austynloehr/stm32_reaction_wheel/Hardware/Balance_Controller/Render.png

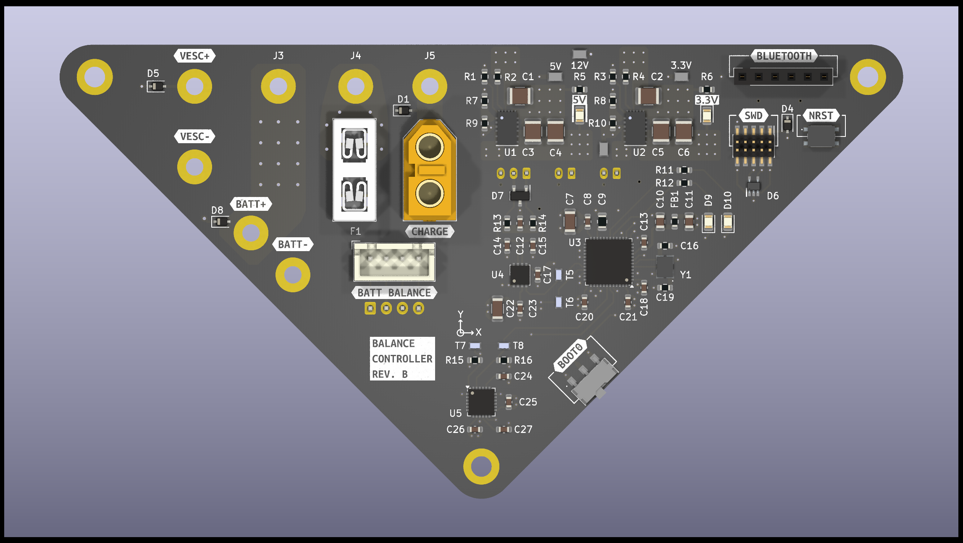
Hardware/Balance_Controller/Render.png
