austynloehr/stm32_reaction_wheel/Resources/Markdowns/HC05.md

# HC-05 Documentation

## AT Mode Configuration
*Note: USB to TTL serial adapter is required for configuration. Ensure logic levels are 3.3V. Recommend [this adapter](https://www.amazon.com/DSD-TECH-Adapter-FT232RL-Compatible/dp/B07BBPX8B8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).*<br>

1. Plug-in TTL adapter to computer
2. Set TTL adapter to 3.3V logic level
3. While holding mode button, power HC-05 with 5V supply separate from TTL adapter. Verify LED is blinking
    * Ensure supply and TTL GND's are connected
4. Open serial port monitor of choice (I am using Arduino serial monitor)
5. Default serial settings are 38400 baud, Both NL & CR
6. Send "AT" command, verify "OK" response
7. Get module MAC address. Take note of this for later use in [ble_serial_monitor.sh](../Scripts/ble_serial_monitor.sh)

        AT+ADDR?
8. Set serial baud rate, verify "OK" response
        
        AT+UART=460800,0,0
9. HC-05 should now be configured for use with STM32 UART config
