austynloehr/stm32_reaction_wheel/Hardware/Balance_Controller/EBOM_RevB.xlsx

Balance Controller EBOM (Rev. B)
# | Designator | Qty | Value | Footprint | Mfg Part # | Manufacturer
1 | C9 | 1 | 4.7u | Resistor_SMD:R_0805_2012Metric | GRM21BZ71E475KE15L | Murata
2 | C24 | 1 | 2.2n | Capacitor_SMD:C_0603_1608Metric | GRT1885C1H222JA02D | Murata
3 | C26 | 1 | 10n | Capacitor_SMD:C_0603_1608Metric | GRM1885C1H103JA01J | Murata
4 | D6 | 1 | ESDALC6V1W5 | ESDALC6V1W5:SOT65P210X110-5N | ESDALC6V1W5 | ST
5 | D7 | 1 | NUP2105L | Package_TO_SOT_SMD:SOT-23 | NUP2105L | Diotec
6 | D9 | 1 | GRN | LED_SMD:LED_0805_2012Metric | 150080GS75000 | Wurth Elektronik
7 | D11 | 1 | VESD03A2-03G-G3-08 | Package_TO_SOT_SMD:SOT-323_SC-70 | VESD03A2-03G-G3-08 | Vishay
8 | F1 | 1 | 20A | 534-3568:3568 | 3568 | Keystone Electronics
9 | FB1 | 1 | 120R | Resistor_SMD:R_0603_1608Metric | BLM18KG121TN1D | Murata
10 | J1 | 1 | HC-05 | Connector_PinSocket_2.54mm:PinSocket_1x06_P2.54mm_Vertical | 61300611821 | Wurth Elektronik
11 | J6 | 1 | SWD | Connector_PinHeader_1.27mm:PinHeader_2x05_P1.27mm_Vertical_SMD | FTSH-105-01-LM-DV-K-P-TR | Samtec
12 | J7 | 1 | CHARGE | Connector_AMASS:AMASS_XT60-F_1x02_P7.20mm_Vertical | XT60PB-F | AMASS
13 | J10 | 1 | BAL_BATT_A | Connector_JST:JST_XH_B4B-XH-A_1x04_P2.50mm_Vertical | B4B-XH-A | JST
14 | J12 | 1 | ENABLE | Connector_JST:JST_PH_B2B-PH-K_1x02_P2.00mm_Vertical | B2B-PH-K | JST
15 | J13 | 1 | RGB_LED | Connector_JST:JST_PH_B2B-PH-K_1x02_P2.00mm_Vertical | B2B-PH-K | JST
16 | J14 | 1 | CAN | Connector_JST:JST_PH_B3B-PH-K_1x03_P2.00mm_Vertical | B3B-PH-K | JST
17 | J15 | 1 | BAL_BATT_B | Connector_JST:JST_XH_B4B-XH-A_1x04_P2.50mm_Vertical | B4B-XH-A | JST
18 | R1 | 1 | 53.6k | Resistor_SMD:R_0603_1608Metric | ERJ-PA3F5362V | Panasonic
19 | R3 | 1 | 39k | Resistor_SMD:R_0603_1608Metric | ERJ-UP3J393V | Panasonic
20 | R5 | 1 | 523 | Resistor_SMD:R_0603_1608Metric | ERJ-PA3F5230V | Panasonic
21 | R7 | 1 | 34k | Resistor_SMD:R_0603_1608Metric | ERJ-PB3D3402V | Panasonic
22 | R8 | 1 | 40.2k | Resistor_SMD:R_0603_1608Metric | RCS060340K2FKEA | Vishay
23 | R9 | 1 | 6.49k | Resistor_SMD:R_0603_1608Metric | ERJ-PA3F6491V | Panasonic
24 | R10 | 1 | 12.7k | Resistor_SMD:R_0603_1608Metric | CRCW060312K7FKEAHP | Vishay
25 | R12 | 1 | 15 | Resistor_SMD:R_0603_1608Metric | ERJ-UP3F15R0V | Panasonic
26 | SW1 | 1 | NRST | PTS815_SJG_250_SMTR_LFS:PTS815SJG250SMTRLFS | PTS815 SJG 250 SMTR LFS | C&K
27 | SW2 | 1 | BOOT0 | AYZ0102AURLC:AYZ0102AURLC | AYZ0102AURLC | C&K
28 | U3 | 1 | STM32F412CGU6 | STM32F412:QFN-48-1EP_7x7mm_P0.5mm_EP5.6x5.6mm | STM32F412CGU6 | ST
29 | U4 | 1 | TJA1051TK-3 | Package_DFN_QFN:DFN-8-1EP_3x3mm_P0.65mm_EP1.55x2.4mm | TJA1051TK/3,118 | NXP
30 | U5 | 1 | MPU-6050 | MPU6050:InvenSense_QFN-24_4x4mm_P0.5mm | MPU-6050 | TDK InvenSense
31 | Y1 | 1 | NX3225SA-16.000 | NX3225SA-16.000M-STD-CRS-2:NX3225SA16000MSTDCRS2 | NX3225SA-16.000M-STD-CRS-2 | NDK
32 | C7,C22 | 2 | 10u | Capacitor_SMD:C_1206_3216Metric | GRM31CR71E106MA12L | Murata
33 | C10,C11 | 2 | 1u | Capacitor_SMD:C_0805_2012Metric | GRM21BR71C105KA01K | Murata
34 | C12,C23 | 2 | 47n | Capacitor_SMD:C_0603_1608Metric | GCJ188R71C473KA01D | Murata
35 | C14,C15 | 2 | 100p | Capacitor_SMD:C_0603_1608Metric | GCM1885C1H101JA16J | Murata
36 | C16,C19 | 2 | 6p | Resistor_SMD:R_0603_1608Metric | GRM1885C2A6R0DA01D | Murata
37 | R2,R4 | 2 | 100k | Resistor_SMD:R_0603_1608Metric | ERJ-UP3F1003V | Panasonic
38 | R6,R11 | 2 | 220 | Resistor_SMD:R_0603_1608Metric | ERJ-UP3J221V | Panasonic
39 | R13,R14 | 2 | 60 | Resistor_SMD:R_0603_1608Metric | ERJ-UP3F60R4V | Panasonic
40 | R15,R16 | 2 | 4.7k | Resistor_SMD:R_0603_1608Metric | MCT0603MD4701BP500 | Vishay
41 | R17,R18 | 2 | 10k | Resistor_SMD:R_0603_1608Metric | ESR03EZPJ103 | ROHM
42 | U1,U2 | 2 | MPM3610GQV-P | QFN3p0x5p0x1p6_MPM3610_MNP | MPM3610GQV-P | Monolithic Power Systems
43 | D1,D5,D8 | 3 | D_TVS | Diode_SMD:D_SOD-323 | PJGBLC12CR100001 | Panjit
44 | D2,D3,D10 | 3 | RED | LED_SMD:LED_0805_2012Metric | 150080SS75000 | Wurth Elektronik
45 | D4,D12,D13,D14 | 4 | SC1533-01FTG | Diode_SMD:D_SOD-323 | SC1533-01FTG | Littelfuse
46 | T1,T2,T3,T4 | 4 | TestPoint | RCT-0C:RCT-0C | RCT-0C | TE
47 | T5,T6,T7,T8 | 4 | TestPoint | RCU-0C:TP+195X110 | RCU-0C | TE
48 | C1,C2,C3,C4,C5,C6 | 6 | 22u | Capacitor_SMD:C_1210_3225Metric | GRM32ER71E226KE15L | Murata
49 | C8,C13,C17,C18,C20,C21,C25,C27,C28 | 9 | 100n | Capacitor_SMD:C_0603_1608Metric | GRM188R72A104KA35J | Murata
