austynloehr/stm32_reaction_wheel/Hardware/Balance_Controller/Components/LIB_3568/3568/3D/3568.stp

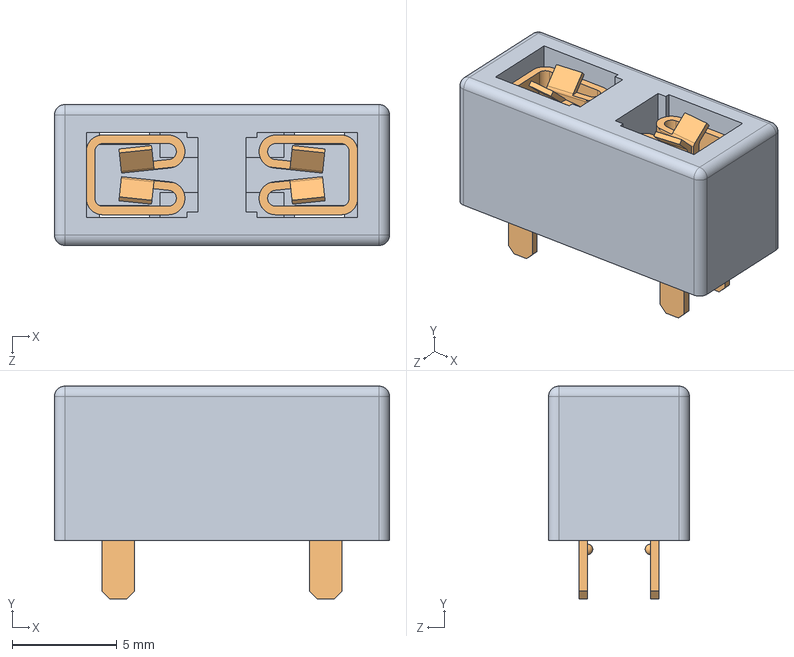
[picture p2: CAD file, 2024-02-08]
Hardware/Balance_Controller/Components/LIB_3568/3568/3D/3568.stp
16.0 x 10.2 x 6.73 mm
