austynloehr/stm32_reaction_wheel/Hardware/Balance_Controller/Components/LIB_AYZ0102AURLC/AYZ0102AURLC/3D/AYZ0102AURLC.stp

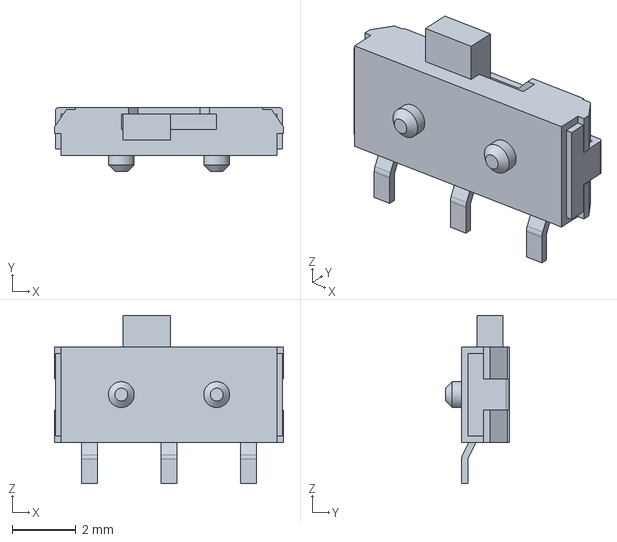
[picture p3: CAD file, 2024-02-08]
Hardware/Balance_Controller/Components/LIB_AYZ0102AURLC/AYZ0102AURLC/3D/AYZ0102AURLC.stp
7.20 x 2.00 x 5.29 mm
