austynloehr/stm32_reaction_wheel/Hardware/Balance_Controller/Components/LIB_ESDALC6V1W5/3D/ESDALC6V1W5.stp

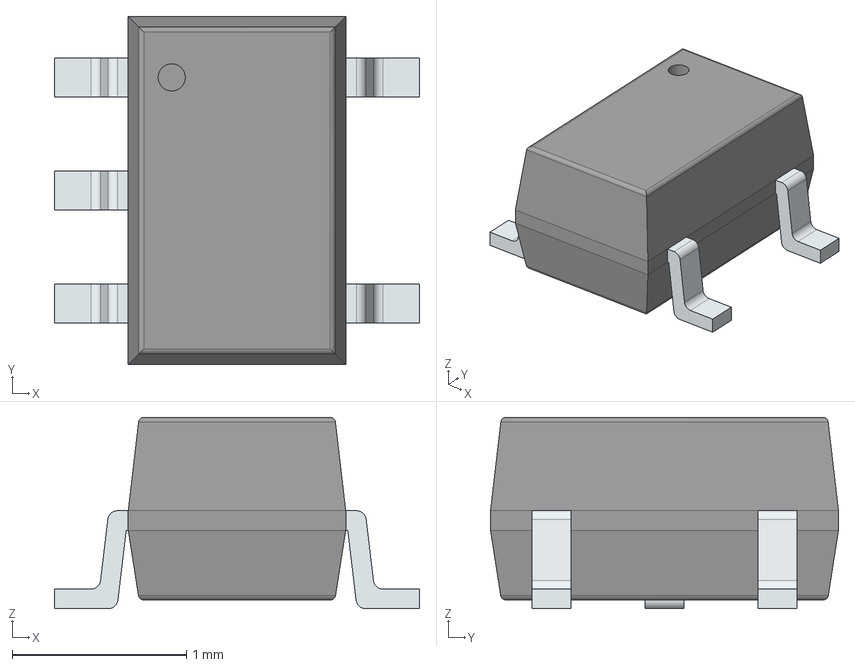
[picture p4: CAD file, 2024-03-23]
Hardware/Balance_Controller/Components/LIB_ESDALC6V1W5/3D/ESDALC6V1W5.stp
2.10 x 2.00 x 1.10 mm
PinsArrayL
PinsArrayR
