austynloehr/stm32_reaction_wheel/Hardware/Balance_Controller/Components/LIB_MCP111T-195I_LB/MCP111T-195I_LB/3D/MCP111T-195I_LB.stp

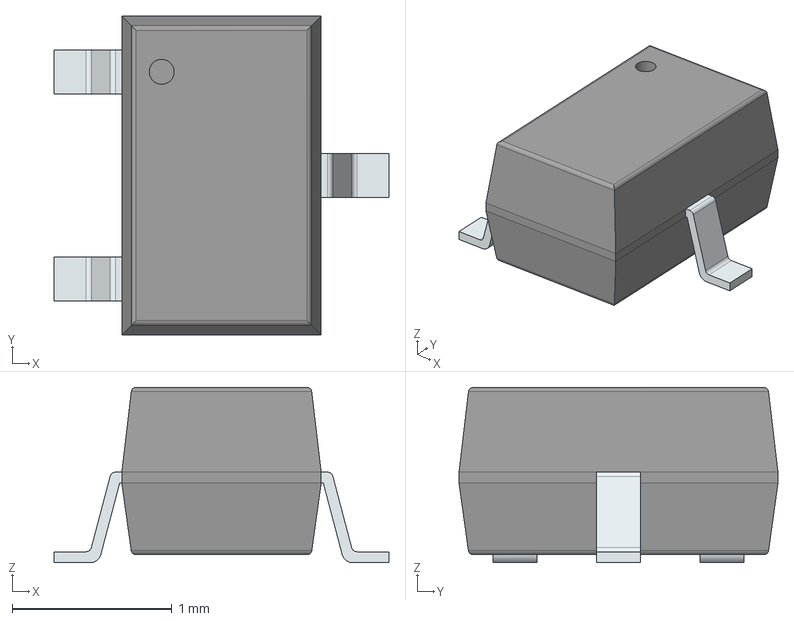
[picture p5: CAD file, 2024-02-08]
Hardware/Balance_Controller/Components/LIB_MCP111T-195I_LB/MCP111T-195I_LB/3D/MCP111T-195I_LB.stp
2.10 x 2.00 x 1.10 mm
PinsArrayL
FilletPinR
