austynloehr/stm32_reaction_wheel/Hardware/Balance_Controller/Components/LIB_PTS815_SJG_250_SMTR_LFS/PTS815_SJG_250_SMTR_LFS/3D/PTS815_SJG_250_SMTR_LFS.stp

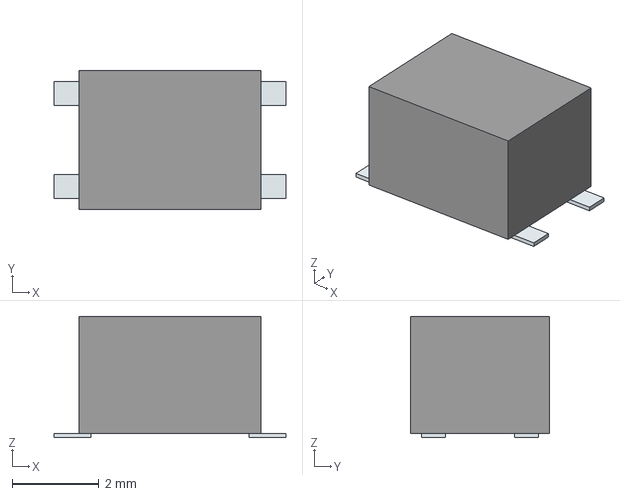
[picture p6: CAD file, 2024-02-08]
Hardware/Balance_Controller/Components/LIB_PTS815_SJG_250_SMTR_LFS/PTS815_SJG_250_SMTR_LFS/3D/PTS815_SJG_250_SMTR_LFS.stp
5.36 x 3.20 x 2.80 mm
Pins
