austynloehr/stm32_reaction_wheel/Hardware/Balance_Controller/Components/LIB_RCT-0C/c-1625854-2-ba-3d.stp

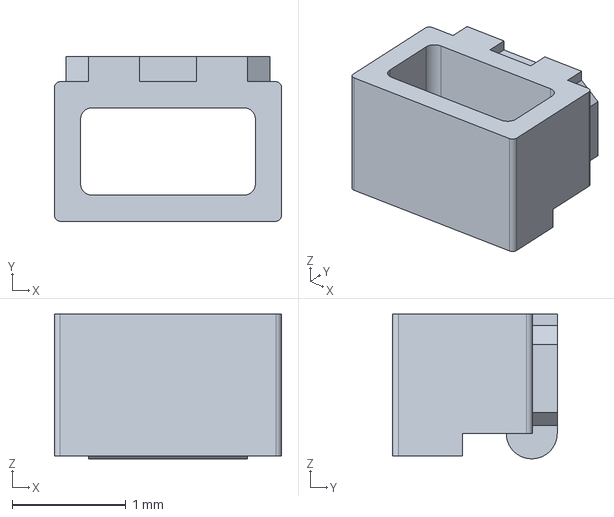
[picture p7: CAD file, 2024-03-23]
Hardware/Balance_Controller/Components/LIB_RCT-0C/c-1625854-2-ba-3d.stp
2.00 x 1.45 x 1.28 mm
