austynloehr/stm32_reaction_wheel/Hardware/Balance_Controller/Components/LIB_SBM3060VDC-AU_R2_006A1/SBM3060VDC-AU_R2_006A1/3D/SBM3060VDC-AU_R2_006A1.stp

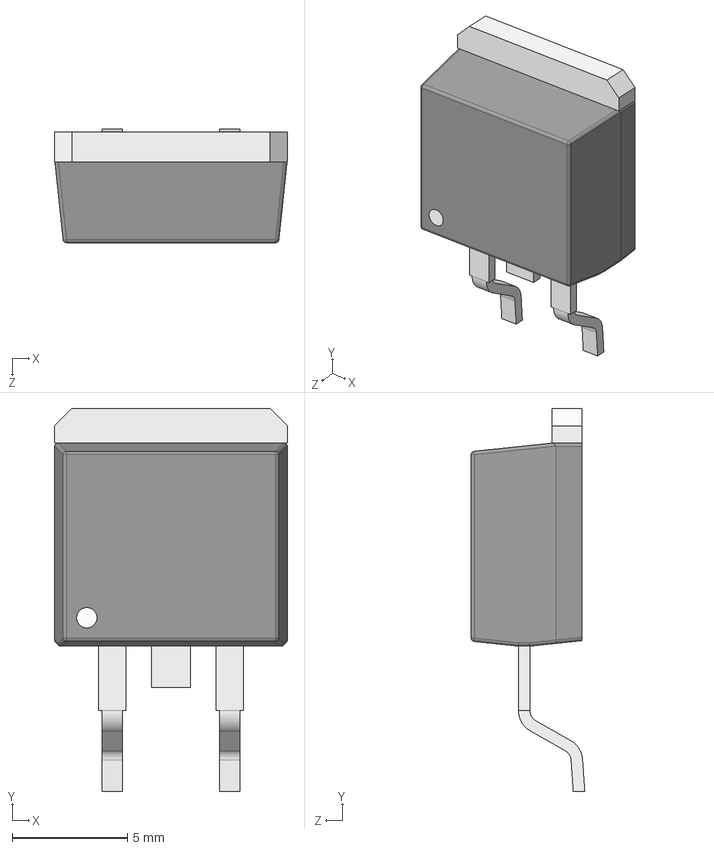
[picture p8: CAD file, 2024-02-08]
Hardware/Balance_Controller/Components/LIB_SBM3060VDC-AU_R2_006A1/SBM3060VDC-AU_R2_006A1/3D/SBM3060VDC-AU_R2_006A1.stp
10.1 x 16.6 x 4.92 mm
