austynloehr/stm32_reaction_wheel/Hardware/Balance_Controller/Components/NX3225SA-16.000M-STD-CRS-2/3D/NX3225SA-16.000M-STD-CRS-2.stp

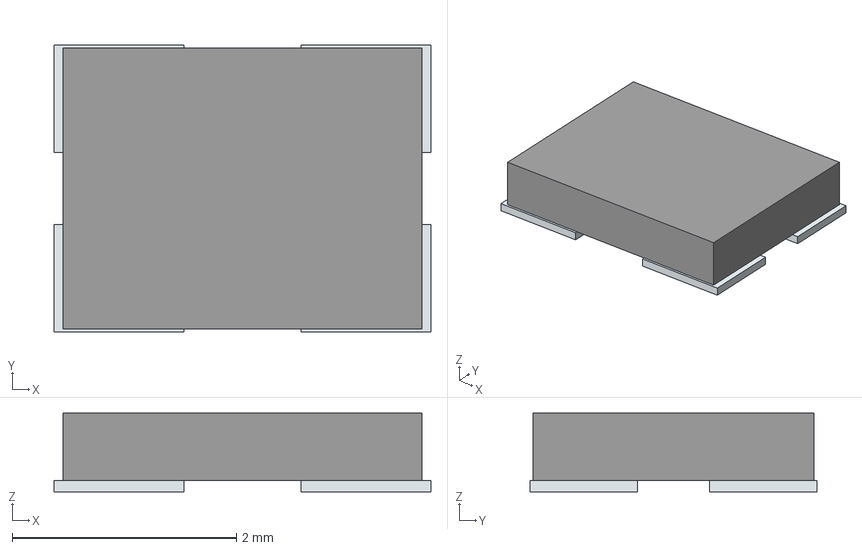
[picture p9: CAD file, 2024-02-08]
Hardware/Balance_Controller/Components/NX3225SA-16.000M-STD-CRS-2/3D/NX3225SA-16.000M-STD-CRS-2.stp
3.36 x 2.56 x 0.7 mm
Pins
