austynloehr/stm32_reaction_wheel/Hardware/Balance_Controller/Components/RCU-0C/RCU-0C.step

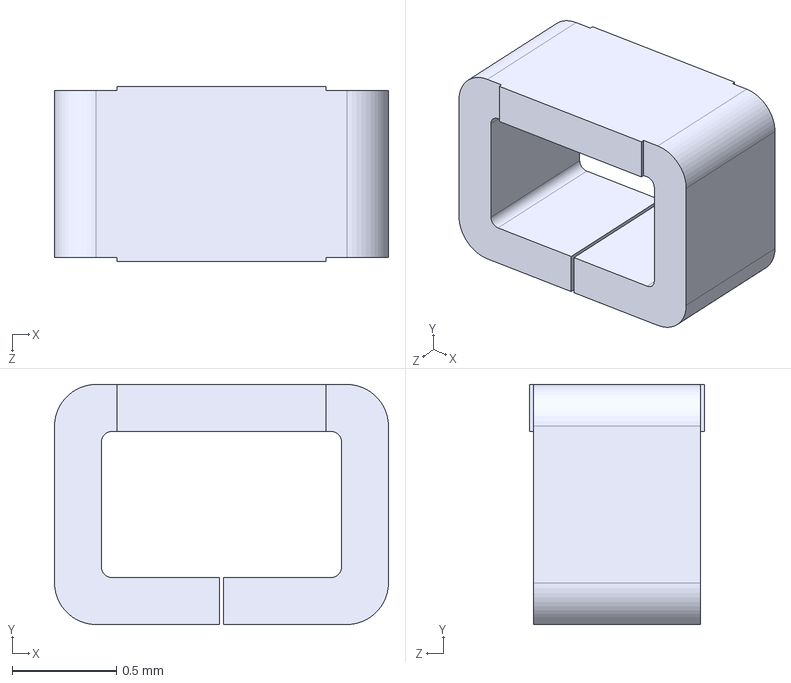
[picture p10: CAD file, 2024-02-08]
Hardware/Balance_Controller/Components/RCU-0C/RCU-0C.step
1.60 x 1.15 x 0.84 mm
