austynloehr/stm32_reaction_wheel/Hardware/Balance_Controller/Components/RN4871_I_RM140/3D/RN4871-I_RM128.stp

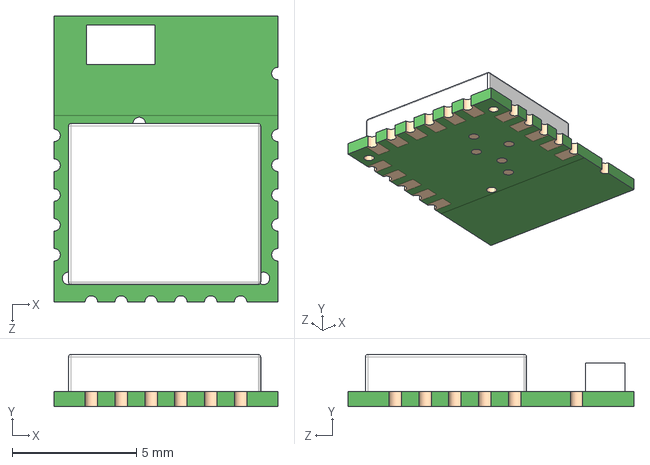
[picture p11: CAD file, 2024-02-08]
Hardware/Balance_Controller/Components/RN4871_I_RM140/3D/RN4871-I_RM128.stp
9.00 x 2.10 x 11.5 mm
