austynloehr/stm32_reaction_wheel/Hardware/Balance_Controller/Components/TPS2116DRLR/3D/TPS2116DRLR.stp

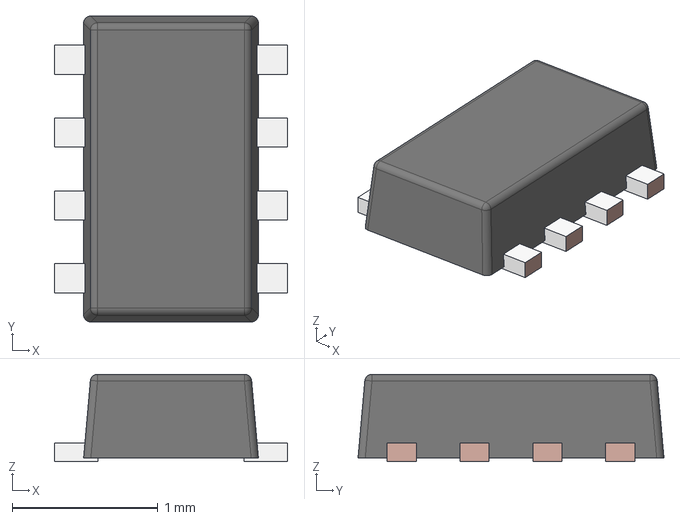
[picture p12: CAD file, 2024-02-08]
Hardware/Balance_Controller/Components/TPS2116DRLR/3D/TPS2116DRLR.stp
1.60 x 2.10 x 0.6 mm
FRAME-DRL0008A
BODY-SOT
