austynloehr/stm32_reaction_wheel/Hardware/Reaction_Wheel/flywheel_remake.SLDPRT

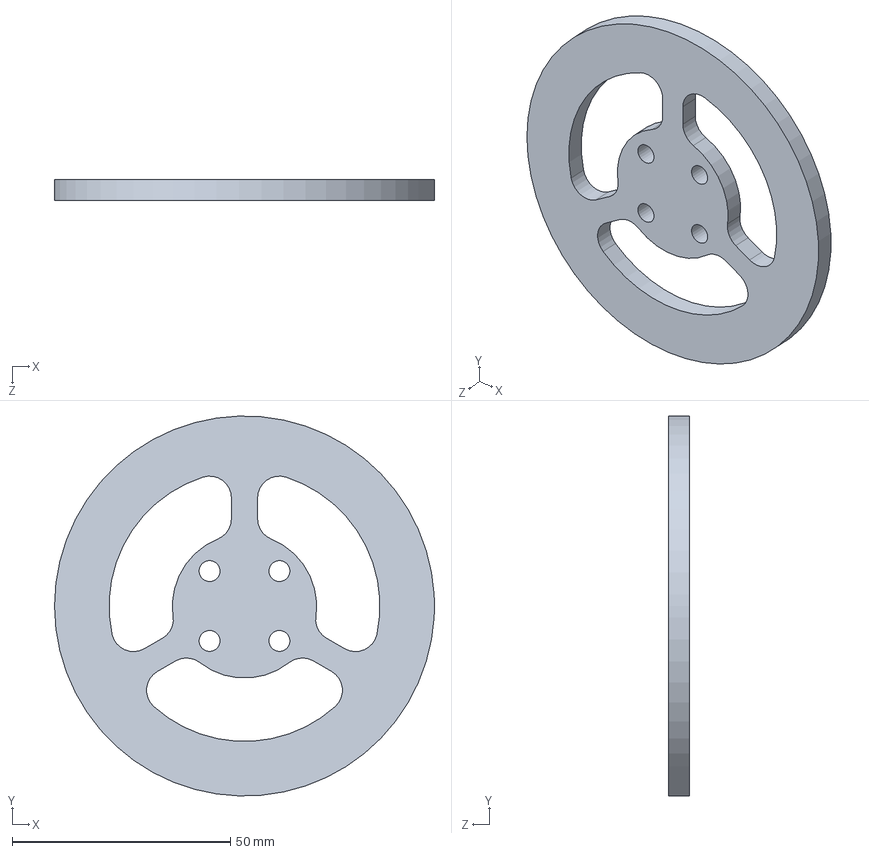
[picture p13: CAD file, 2024-02-08]
Hardware/Reaction_Wheel/flywheel_remake.SLDPRT
87.0 x 87.0 x 4.75 mm
