austynloehr/stm32_reaction_wheel/Hardware/Reaction_Wheel/mfg/battery_bracket.stl

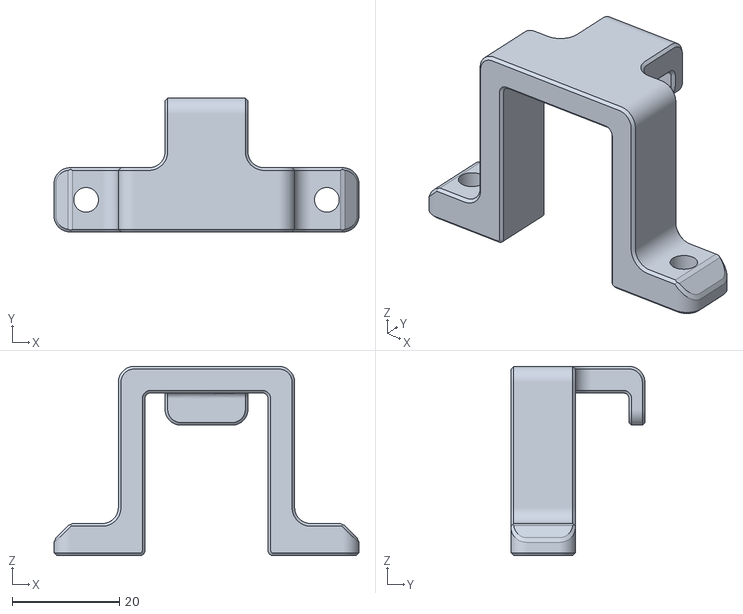
[picture p14: CAD file, 2024-12-26]
Hardware/Reaction_Wheel/mfg/battery_bracket.stl
56.9 x 25.0 x 35.3
