austynloehr/stm32_reaction_wheel/Hardware/Reaction_Wheel/mfg/pulley_spacer.stl

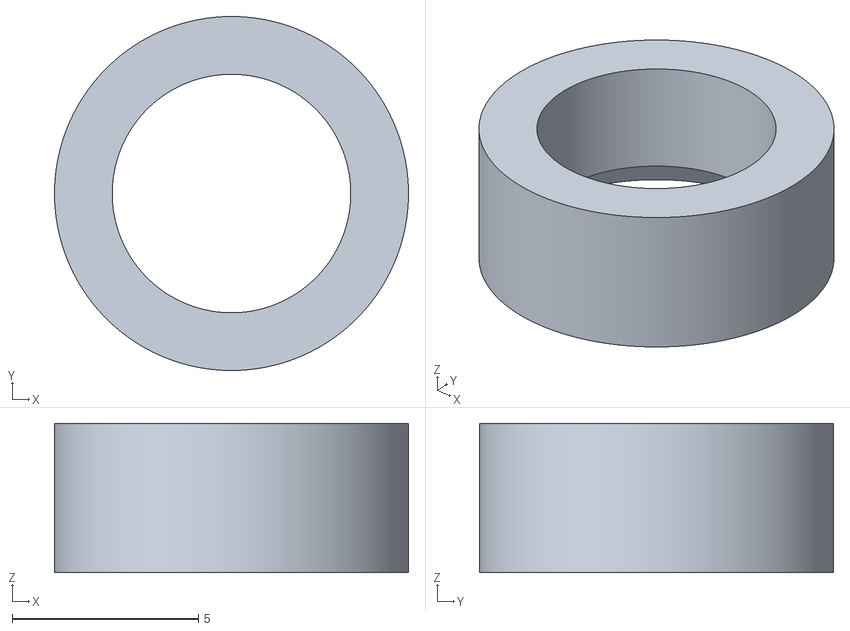
[picture p15: CAD file, 2024-12-26]
Hardware/Reaction_Wheel/mfg/pulley_spacer.stl
9.50 x 9.50 x 4.00
