austynloehr/stm32_reaction_wheel/(list of files, cad)

Other CAD files:
Hardware/Reaction_Wheel/mfg/flywheel.STEP
Hardware/Reaction_Wheel/1314-0016-0250.prt
Hardware/Reaction_Wheel/1606-0043-0250.prt
Hardware/Reaction_Wheel/1621-1632-0006.prt
Hardware/Reaction_Wheel/3764N137.prt
Hardware/Reaction_Wheel/3S_850_LIPO.prt
Hardware/Reaction_Wheel/57155K324.prt
Hardware/Reaction_Wheel/91292A116.prt
Hardware/Reaction_Wheel/91801A154.prt
Hardware/Reaction_Wheel/91801A156.prt
Hardware/Reaction_Wheel/INSERT_THRD_M3_6MM.prt
Hardware/Reaction_Wheel/REV-21-1908.prt
Hardware/Reaction_Wheel/ReactionWheel.prt
Hardware/Reaction_Wheel/VESC_DC_PWR.prt
Hardware/Reaction_Wheel/VESC_EDU.prt
Hardware/Reaction_Wheel/XT60H-F.prt
Hardware/Reaction_Wheel/batt_bracket.prt
Hardware/Reaction_Wheel/belt_spaceclaim.prt
Hardware/Reaction_Wheel/chassis_a _v2.prt
Hardware/Reaction_Wheel/chassis_a _v3.prt
Hardware/Reaction_Wheel/chassis_a.prt
Hardware/Reaction_Wheel/flywheel_mfg.prt
Hardware/Reaction_Wheel/flywheel_shaft.prt
Hardware/Reaction_Wheel/pulley_spacer.prt
