austynloehr/stm32_reaction_wheel/(threads)

Thread 6 (2023-07-19):

Battery selection

austynloehr, 2023-07-19:
Research options for batteries and down-select component / wiring

austynloehr, 2024-03-23:
Chose BetaFPV 850mAh LiPo battery

Closed 2024-03-23.

Thread 15 (2024-01-06):

Interupt/DMA UART

austynloehr, 2024-01-06:
Currently use STM32 HAL polling UART driver. This seems to take ~3-5ms to send logging data to BLE module. Investigate switching to DMA/interrupt-based UART implementation to reduce processing time.

austynloehr, 2024-12-26:
Ended up implementing DMA to write UART data

austynloehr, 2024-12-26:
Ended up implementing DMA to write UART data

Closed 2024-12-26.

Thread 17 (2024-03-09):

Revise balance controller PCB

austynloehr, 2024-03-09:
- Remove 12V regen diode
- Remove RN4871 and components
- Add HC05 power and signal header
- Update MCU programming connector

Closed 2024-03-23.
