austynloehr/stm32_reaction_wheel/Hardware/Balance_Controller/Schematic_Rev_B.pdf

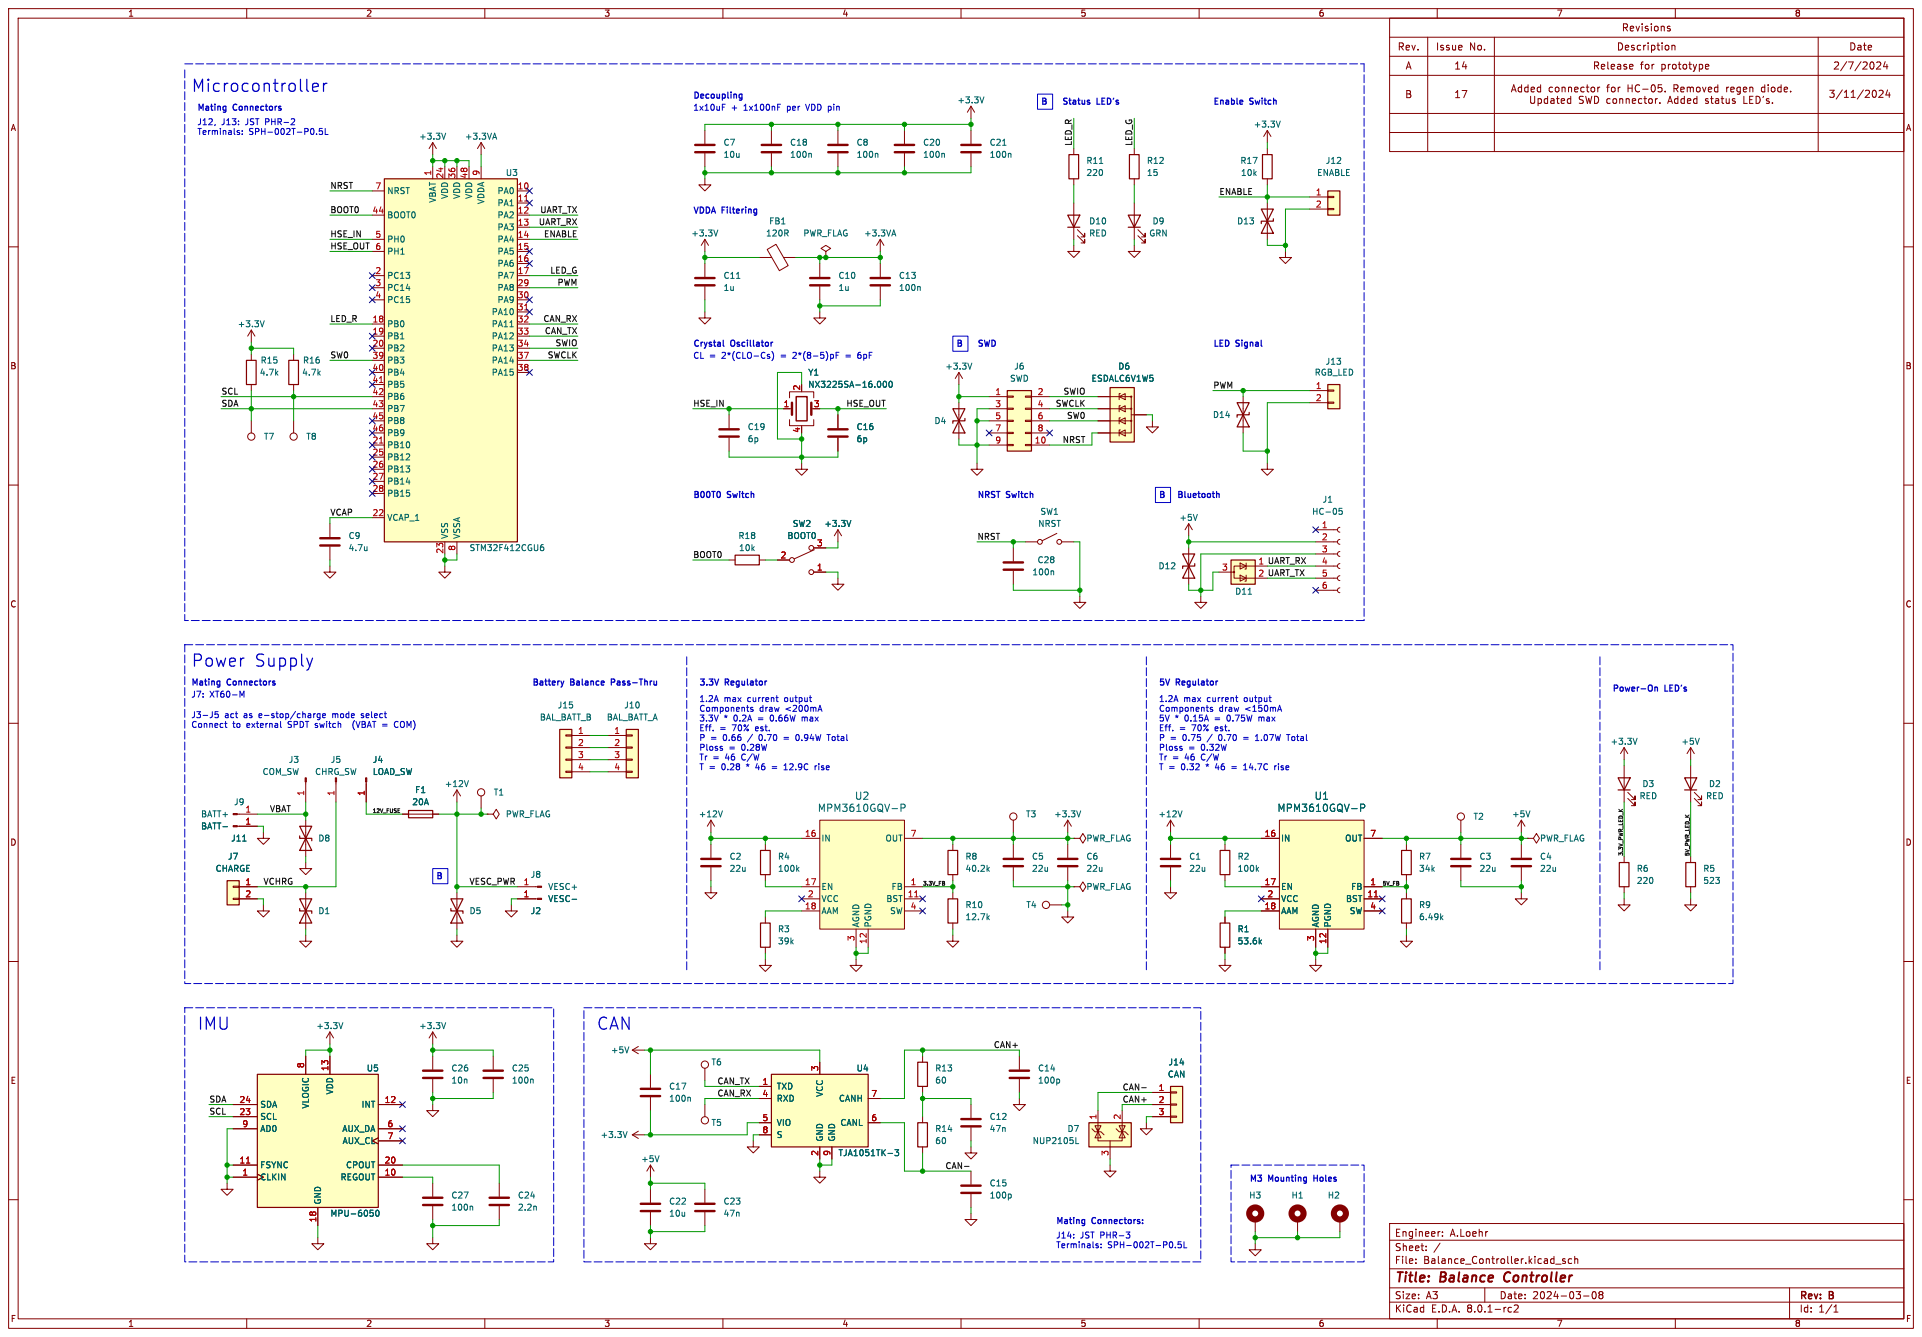
[picture p16: page 1]

1 PA0 10 PA1 11 PA2 12 PA3 13 PA4 14 PA5 15 PA6 16 PA7 17 PB0 18 PB1 19 PC13 2 PB2 20 PB10 21 VCAP_1 22 VSS 23 VDD 24 PB12 25 PB13 26 PB14 27 PB15 28 PA8 29 PC14 3 PA9 30 PA10 31 PA11 32 PA12 33 PA13 34 VDD 36 PA14 37 PA15 38 PB3 39 PC15 4 PB4 40 PB5 41 PB6 42 PB7 43 BOOT0 44 PB8 45 PB9 46 VDD 48 PH0 5 PH1 6 NRST 7 VSSA

Battery Balance Pass-Thru

3.3V * 0.2A = 0.66W max Eff. = 70% est. P = 0.66 / 0.70 = 0.94W Total Ploss = 0.28W

5V * 0.15A = 0.75W max Eff. = 70% est. P = 0.75 / 0.70 = 1.07W Total Ploss = 0.32W

3 RXD 4 VIO 5 CANL 6 CANH 7 S
