austynloehr/stm32_reaction_wheel/Hardware/Balance_Controller/Balance_Controller.kicad_pcb

## KiCad design Hardware/Balance_Controller/Balance_Controller.kicad_pcb (2024-03-23)

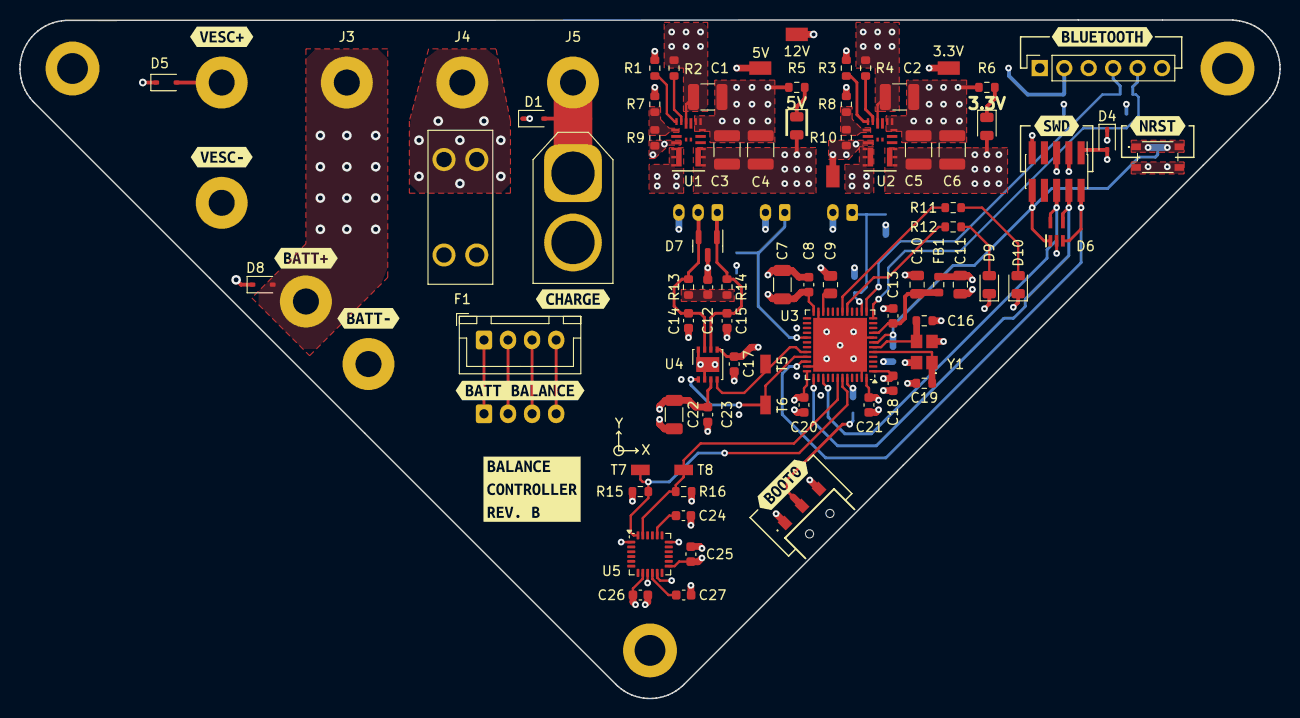
[picture p17: board Balance_Controller.kicad_pcb from above]

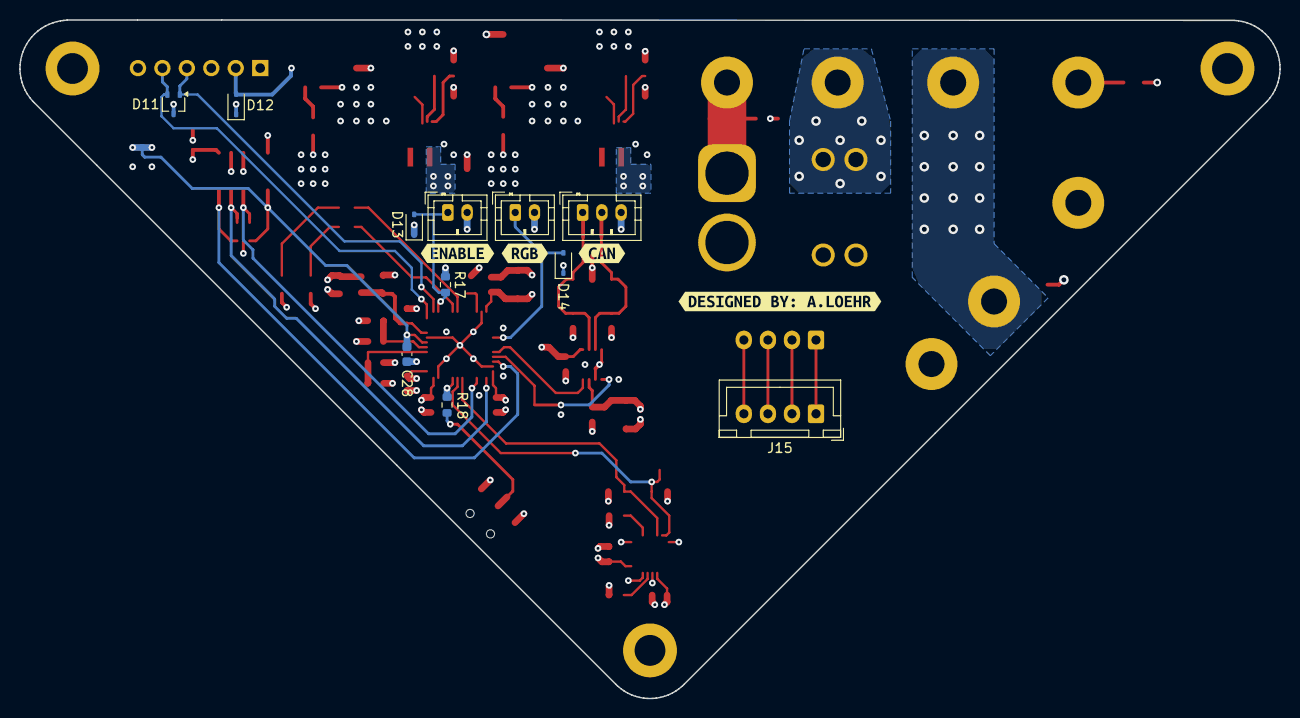
[picture p18: board Balance_Controller.kicad_pcb from below]

Board: 4 copper layers, 130.9 x 70.5 mm, 111 parts (15 on the bottom side), 46 nets.

Parts:
C1, C2, C3, C4, C5, C6: 22u; C_1210_3225Metric
C7, C22: 10u; C_1206_3216Metric
C8, C13, C17, C18, C20, C21, C25, C27, C28: 100n; C_0603_1608Metric
C9: 4.7u; R_0805_2012Metric
C10, C11: 1u; C_0805_2012Metric
C12, C23: 47n; C_0603_1608Metric
C14, C15: 100p; C_0603_1608Metric
C16, C19: 6p; R_0603_1608Metric
C24: 2.2n; C_0603_1608Metric
C26: 10n; C_0603_1608Metric
D1, D5, D8: D_TVS; D_SOD-323
D2, D3, D10: RED; LED_0805_2012Metric
D4, D12, D13, D14: SC1533-01FTG; D_SOD-323
D6: ESDALC6V1W5; SOT65P210X110-5N
D7: NUP2105L; SOT-23
D9: GRN; LED_0805_2012Metric
D11: VESD03A2-03G-G3-08; SOT-323_SC-70
F1: 20A; 3568
FB1: 120R; R_0603_1608Metric
H1, H2, H3: MountingHole_Pad; MountingHole_3.2mm_M3_DIN965_Pad
J1: HC-05; PinSocket_1x06_P2.54mm_Vertical
J2: VESC-; MountingHole_2.7mm_Pad
J3: COM_SW; MountingHole_2.7mm_Pad
J4: LOAD_SW; MountingHole_2.7mm_Pad
J5: CHRG_SW; MountingHole_2.7mm_Pad
J6: SWD; PinHeader_2x05_P1.27mm_Vertical_SMD
J7: CHARGE; AMASS_XT60-F_1x02_P7.20mm_Vertical
J8: VESC+; MountingHole_2.7mm_Pad
J9: BATT+; MountingHole_2.7mm_Pad
J10: BAL_BATT_A; JST_XH_B4B-XH-A_1x04_P2.50mm_Vertical
J11: BATT-; MountingHole_2.7mm_Pad
J12: ENABLE; JST_PH_B2B-PH-K_1x02_P2.00mm_Vertical
J13: RGB_LED; JST_PH_B2B-PH-K_1x02_P2.00mm_Vertical
J14: CAN; JST_PH_B3B-PH-K_1x03_P2.00mm_Vertical
J15: BAL_BATT_B; JST_XH_B4B-XH-A_1x04_P2.50mm_Vertical
R1: 53.6k; R_0603_1608Metric
R2, R4: 100k; R_0603_1608Metric
R3: 39k; R_0603_1608Metric
R5: 523; R_0603_1608Metric
R6, R11: 220; R_0603_1608Metric
R7: 34k; R_0603_1608Metric
R8: 40.2k; R_0603_1608Metric
R9: 6.49k; R_0603_1608Metric
R10: 12.7k; R_0603_1608Metric
R12: 15; R_0603_1608Metric
R13, R14: 60; R_0603_1608Metric
R15, R16: 4.7k; R_0603_1608Metric
R17, R18: 10k; R_0603_1608Metric
SW1: NRST; PTS815SJG250SMTRLFS
SW2: BOOT0; AYZ0102AURLC
T1, T2, T3, T4: TestPoint; RCT-0C
T5, T6, T7, T8: TestPoint; TP+195X110
U1, U2: MPM3610GQV-P; QFN3p0x5p0x1p6_MPM3610_MNP
U3: STM32F412CGU6; QFN-48-1EP_7x7mm_P0.5mm_EP5.6x5.6mm
U4: TJA1051TK-3; DFN-8-1EP_3x3mm_P0.65mm_EP1.55x2.4mm
U5: MPU-6050; InvenSense_QFN-24_4x4mm_P0.5mm
Y1: NX3225SA-16.000; NX3225SA16000MSTDCRS2
kibuzzard-1: G***; kibuzzard-65EC859F
kibuzzard-2: G***; kibuzzard-65EE22FE
kibuzzard-3: G***; kibuzzard-65C181EB
kibuzzard-4: G***; kibuzzard-65C183BF
kibuzzard-5: G***; kibuzzard-65C187BD
kibuzzard-6: G***; kibuzzard-65EE0D80
kibuzzard-7: G***; kibuzzard-65EBE841
kibuzzard-8: G***; kibuzzard-65C18803
kibuzzard-9: G***; kibuzzard-65C1883A
kibuzzard-10: G***; kibuzzard-65C18854
kibuzzard-11: G***; kibuzzard-65C185CB
kibuzzard-65EE6C62: G***; kibuzzard-65EE6C62
kibuzzard-65EE6C92: G***; kibuzzard-65EE6C92
kibuzzard-65EE6CA7: G***; kibuzzard-65EE6CA7
kibuzzard-65EE6CAC: G***; kibuzzard-65EE6CAC

Connections:
+3.3V: C5.1, C6.1, C7.1, C8.1, C11.1, C17.2, C18.1, C20.1, C21.1, C25.1, C26.1, D3.2 (A), D4.2 (A2), FB1.2, J6.1, R8.1, R15.2, R16.2, R17.2, SW2.3 (A), T3.1, U2.7 (OUT), U2.8 (OUT), U2.9 (OUT), U3.1 (VBAT), U3.24 (VDD), U3.36 (VDD), U3.48 (VDD), U4.5 (VIO), U5.8 (VLOGIC), U5.13 (VDD)
+3.3VA: C10.1, C13.1, FB1.1, U3.9 (VDDA)
+5V: C3.1, C4.1, C17.1, C22.1, C23.2, D2.2 (A), D12.2 (A2), J1.2, R7.1, T2.1, U1.7 (OUT), U1.8 (OUT), U1.9 (OUT), U4.3 (VCC)
+12V: C1.1, C2.1, D5.2 (A2), F1.1, F1.2, J8.1, R2.1, R4.1, T1.1, U1.16 (IN), U2.16 (IN)
/3.3V_FB: R8.2, R10.1, U2.1 (FB)
/3.3V_PWR_LED_K: D3.1 (K), R6.1
/5V_FB: R7.2, R9.1, U1.1 (FB)
/5V_PWR_LED_K: D2.1 (K), R5.1
/12V_FUSE: F1.3, F1.4, J4.1
/BOOT0: R18.1, U3.44 (BOOT0)
/CAN+: C14.1, D7.2 (K), J14.2, R13.1, U4.7 (CANH)
/CAN-: C15.1, D7.1 (K), J14.1, R14.2, U4.6 (CANL)
/CAN_RX: T5.1, U3.32 (PA11), U4.4 (RXD)
/CAN_TX: T6.1, U3.33 (PA12), U4.1 (TXD)
/ENABLE: D13.2 (A2), J12.1, R17.1, U3.14 (PA4)
/HSE_IN: C19.1, U3.5 (PH0), Y1.1
/HSE_OUT: C16.1, U3.6 (PH1), Y1.3
/LED_G: R12.1, U3.17 (PA7)
/LED_R: R11.1, U3.18 (PB0)
/NRST: C28.1, D6.1 (IO1), J6.10, SW1.1, SW1.2, U3.7 (NRST)
/PWM: D14.2 (A2), J13.1, U3.29 (PA8)
/SCL: R16.1, T8.1, U3.42 (PB6), U5.23 (SCL)
/SDA: R15.1, T7.1, U3.43 (PB7), U5.24 (SDA)
/SW0: D6.5 (IO4), J6.6, U3.39 (PB3)
/SWCLK: D6.4 (IO3), J6.4, U3.37 (PA14)
/SWIO: D6.3 (IO2), J6.2, U3.34 (PA13)
/UART_RX: D11.1 (IO1), J1.4, U3.13 (PA3)
/UART_TX: D11.2 (IO2), J1.5, U3.12 (PA2)
/VBAT: D8.2 (A2), J3.1, J9.1
/VCAP: C9.1, U3.22 (VCAP_1)
/VCHRG: D1.2 (A2), J5.1, J7.1
GND: C1.2, C2.2, C3.2, C4.2, C5.2, C6.2, C7.2, C8.2, C9.2, C10.2, C11.2, C12.1, C13.2, C14.2, C15.2, C16.2, C18.2, C19.2, C20.2, C21.2, C22.2, C23.1, C24.2, C25.2, C26.2, C27.2, C28.2, D1.1 (A1), D4.1 (A1), D5.1 (A1), D6.2 (GND), D7.3 (A), D8.1 (A1), D9.1 (K), D10.1 (K), D11.3 (GND), D12.1 (A1), D13.1 (A1), D14.1 (A1), H1.1, H2.1, H3.1, J1.3, J2.1, J6.3, J6.5, J6.9, J7.2, J11.1, J12.2, J13.2, J14.3, R1.2, R3.2, R5.2, R6.2, R9.2, R10.2, SW1.3, SW1.4, SW2.1 (C), T4.1, U1.3 (AGND), U1.12 (PGND), U1.13 (PGND), U1.14 (PGND), U2.3 (AGND), U2.12 (PGND), U2.13 (PGND), U2.14 (PGND), U3.8 (VSSA), U3.23 (VSS), U3.35 (VSS), U3.47 (VSS), U3.49 (VSS), U4.2 (GND), U4.8 (S), U4.9 (GND), U5.1 (CLKIN), U5.9 (AD0), U5.11 (FSYNC), U5.18 (GND), Y1.2, Y1.4
unnamed: C12.2, R13.2, R14.1
unnamed: D9.2 (A), R12.2
unnamed: D10.2 (A), R11.2
unnamed: J10.1, J15.1
unnamed: J10.2, J15.2
unnamed: J10.3, J15.3
unnamed: J10.4, J15.4
unnamed: R18.2, SW2.2 (B)
unnamed: R1.1, U1.18 (AAM)
unnamed: R2.2, U1.17 (EN)
unnamed: R3.1, U2.18 (AAM)
unnamed: R4.2, U2.17 (EN)
unnamed: C24.1, U5.20 (CPOUT)
unnamed: C27.1, U5.10 (REGOUT)
