austynloehr/stm32_reaction_wheel/ReactionWheel_F412/ReactionWheel_F412.ioc

Mcu.UserName=STM32F412CGUx
PA11.Signal=CAN1_RX
PA12.Signal=CAN1_TX
PA13.Signal=SYS_JTMS-SWDIO
PA14.Signal=SYS_JTCK-SWCLK
PA2.Signal=USART2_TX
PA3.Signal=USART2_RX
PA4.GPIO_Label=EnableBtn
PA4.Signal=GPIO_Input
PA7.GPIO_Label=GLED
PA7.Signal=GPIO_Output
PA8.GPIO_Label=PWM_LED
PA8.Signal=S_TIM1_CH1
PB0.GPIO_Label=RLED
PB0.Signal=GPIO_Output
PB3.Signal=SYS_JTDO-SWO
PB6.Signal=I2C1_SCL
PB7.Signal=I2C1_SDA
