austynloehr/stm32_reaction_wheel/ReactionWheel_F412/Core/Inc/main.h

#define EnableBtn_Pin GPIO_PIN_4
#define EnableBtn_GPIO_Port GPIOA
#define GLED_Pin GPIO_PIN_7
#define GLED_GPIO_Port GPIOA
#define RLED_Pin GPIO_PIN_0
#define RLED_GPIO_Port GPIOB
#define PWM_LED_Pin GPIO_PIN_8
#define PWM_LED_GPIO_Port GPIOA
