austynloehr/stm32_reaction_wheel/ReactionWheel_F412/Core/Src/Application/Config/Config_MPU6050.c

/*
 * Config_MPU6050.c
 *
 *  Created on: Jul. 12, 2023
 *      Author: aloehr
 */

#include "Config_MPU6050.h"
#include "IO_MPU6050.h"
#include "PR_MPU6050.h"
#include <math.h>

/* Start Defines */
/* Memory Addresses */
#define ACCEL_CONFIG_REG 	0x1C
#define GYRO_CONFIG_REG 	0x1B
#define PWR_MGMT1_REG 		0x6B
#define SMPRT_DIV_REG 		0x19
#define CONFIG_REG 			0x1A

/* Register Data */
#define CLKSEL 				0x00
#define SMPLRT_DIV 			0x07 // Sample Rate [kHz] = 8 / (1 + SMPLRT_DIV)
#define DLPF_CFG 			0x00
/* End Defines */

/* Start local enum definitions */
typedef enum AFS_SEL_enum {
	g2 = 	0x00, // +-2g
	g4 = 	0x01, // +-4g
	g8 = 	0x02, // +-8g
	g16 = 	0x03, // +-16g
} AFS_SEL_enum_t;

typedef enum FS_SEL_enum {
	w250 = 		0x00, // +-250 deg/s
	w500 = 		0x01, // +-500 deg/s
	w1000 = 	0x02, // +-1000 deg/s
	w2000 = 	0x03, // +-2000 deg/s
} FS_SEL_enum_t;
/* End local enum definitions */

/* Start global variable definitions */
const AFS_SEL_enum_t accelRange = g8;
const FS_SEL_enum_t gyroRange = w2000;
/* End global variable definitions */

/* Start static function prototypes */
static void MPU6050_Init(I2C_HandleTypeDef *hi2c);
static MPU6050_IMUSensitivityData_t MPU6050_GetSens(const AFS_SEL_enum_t accelRange, const FS_SEL_enum_t gyroRange);
/* Start static function prototypes */

/* Start global function definitions */
Config_MPU6050_Bus_t Config_MPU6050(I2C_HandleTypeDef *hi2c){
	Config_MPU6050_Bus_t Config_MPU6050_Bus;

	MPU6050_Init(hi2c);

	Config_MPU6050_Bus.Sensitivity = MPU6050_GetSens(accelRange, gyroRange);

	return Config_MPU6050_Bus;
}
/* End global function definitions */

/* Start static function definitions */
static void MPU6050_Init(I2C_HandleTypeDef *hi2c){
	static uint8_t regData;
	static uint8_t numReg = 1;

	/* I2C device check */
	// Raise error later
	HAL_StatusTypeDef deviceCheck = HAL_I2C_IsDeviceReady(hi2c, MPU6050_ADDR, 1, I2C_TIMEOUT);

	if (deviceCheck != HAL_OK){
		Error_Handler();
	}

	/* Wake IMU */
	regData = CLKSEL;
	HAL_I2C_Mem_Write(hi2c, MPU6050_ADDR, PWR_MGMT1_REG, REG_LEN, &regData, numReg, I2C_TIMEOUT);

	/* Calculate SMPLRT_DIV from desired sample rate */
	regData = SMPLRT_DIV;
	HAL_I2C_Mem_Write(hi2c, MPU6050_ADDR, SMPRT_DIV_REG, REG_LEN, &regData, numReg, I2C_TIMEOUT);

	/* Set gyro config */
	regData = (uint8_t) (gyroRange << 3);
	HAL_I2C_Mem_Write(hi2c, MPU6050_ADDR, GYRO_CONFIG_REG, REG_LEN, &regData, numReg, I2C_TIMEOUT);

	/* Set accel config */
	regData = (uint8_t) (accelRange << 3);
	HAL_I2C_Mem_Write(hi2c, MPU6050_ADDR, ACCEL_CONFIG_REG, REG_LEN, &regData, numReg, I2C_TIMEOUT);

	/*Configure low pass filter*/
	regData = DLPF_CFG;
	HAL_I2C_Mem_Write(hi2c, MPU6050_ADDR, CONFIG_REG, REG_LEN, &regData, numReg, I2C_TIMEOUT);
}

static MPU6050_IMUSensitivityData_t MPU6050_GetSens(const AFS_SEL_enum_t accelRange, const FS_SEL_enum_t gyroRange){
	MPU6050_IMUSensitivityData_t IMUSensitivity;

	/* Determine sensor sensitivity based on sensor range */
	switch (accelRange){
	case g2:
		IMUSensitivity.AccelSens = 16384.0;
		break;
	case g4:
		IMUSensitivity.AccelSens = 8192.0;
		break;
	case g8:
		IMUSensitivity.AccelSens = 4096.0;
		break;
	case g16:
		IMUSensitivity.AccelSens = 2048.0;
		break;
	default:
		IMUSensitivity.AccelSens = 0;
		Error_Handler();
	}

	/* Determine sensor sensitivity based on sensor range */
	switch (gyroRange){
	case w250:
		IMUSensitivity.GyroSens = 131.0;
		break;
	case w500:
		IMUSensitivity.GyroSens = 65.5;
		break;
	case w1000:
		IMUSensitivity.GyroSens = 32.8;
		break;
	case w2000:
		IMUSensitivity.GyroSens = 16.4;
		break;
	default:
		IMUSensitivity.GyroSens = 0;
		Error_Handler();
	}

	return IMUSensitivity;
}
/* End static function definitions */
