austynloehr/stm32_reaction_wheel/ReactionWheel_F412/Core/Src/Application/Application.c

/*
 * Application.c
 *
 *  Created on: Jul 9, 2023
 *      Author: aloehr
 */

#include "Application.h"

/* Start Global Variables */
static CT_Bus_t Last_CT_Bus;
/* End Global Variables */

/* Start global function definition */
Config_Bus_t App_Config(Config_HAL_Bus_t Config_HAL_Bus){
	Config_Bus_t Config_Bus;

	// Startup delay for IMU and VESC
	HAL_Delay(7000);

	Config_Bus.Config_HAL_Bus = Config_HAL_Bus;
	Config_Bus.Config_MPU6050_Bus = Config_MPU6050(Config_HAL_Bus.hi2c);

	Config_DSP();
	Config_VESC(Config_HAL_Bus.hcan);

	// Initialize unit delayed bus states
	Last_CT_Bus.CT_PrimaryStateMachine_Bus.CurrentState_enum = Standby;

	return Config_Bus;
}

void App_Main(Config_Bus_t Config_Bus){
	HI_Bus_t HI_Bus;
	IP_Bus_t IP_Bus;
	CT_Bus_t CT_Bus;
	OP_Bus_t OP_Bus;

	HI_Bus = IO_HardwareInputs(Config_Bus);
	IP_Bus = PR_InputProcessing(Config_Bus, HI_Bus, Last_CT_Bus);
	CT_Bus = CT_Control(HI_Bus, IP_Bus);
	OP_Bus = PR_OutputProcessing(CT_Bus);
	IO_HardwareOutputs(Config_Bus, OP_Bus);

	Last_CT_Bus = CT_Bus;

	HAL_Delay(1);
}
/* End global function definition */
