austynloehr/stm32_reaction_wheel/ReactionWheel_F412/Core/Src/Application/IO/IO.c

/*
 * IO_HardwareInputs.c
 *
 *  Created on: Jul. 9, 2023
 *      Author: aloehr
 */
#include "IO.h"

/* Start global function definitions */
HI_Bus_t IO_HardwareInputs(Config_Bus_t Config_Bus){
	HI_Bus_t HI_Bus;

	HI_Bus.HI_MPU6050_Bus = HI_MPU6050(Config_Bus.Config_HAL_Bus.hi2c);
	HI_Bus.HI_DiscreteInput_Bus = HI_DiscreteInput();
	HI_Bus.HI_VESC_Bus = HI_VESC();

	return HI_Bus;
}

void IO_HardwareOutputs(Config_Bus_t Config_Bus, OP_Bus_t OP_Bus){
	HO_VESC(Config_Bus.Config_HAL_Bus.hcan, OP_Bus.OP_VESC_Bus.pTxData, OP_Bus.OP_VESC_Bus.CanID);
	HO_HCO5(Config_Bus.Config_HAL_Bus.huart2, OP_Bus.OP_HC05_Bus.pData, OP_Bus.OP_HC05_Bus.Size);
	HO_DiscreteIO(OP_Bus.OP_DiscreteOutput_Bus.GLEDCmd_bool, OP_Bus.OP_DiscreteOutput_Bus.RLEDCmd_bool);
}
/* End global function definitions */
