austynloehr/stm32_reaction_wheel/Tools/read_bt_data.py

import os
import sys
import time
import serial
import argparse
import datetime
import rerun as rr
import pandas as pd
from lib.bl_frame_handler import BLFrameHandler

SCRIPT_DIR = os.path.dirname(os.path.abspath(__file__))
REPO_DIR = os.path.dirname(SCRIPT_DIR)
LOG_DIR = os.path.join(REPO_DIR, 'Logs')
LOG_NAME = 'log' + time.strftime('_%Y%m%d_%H%M%S')
LOG_PATH = os.path.join(LOG_DIR, LOG_NAME + '.parquet')

BL_CONFIG_PATH = os.path.join(REPO_DIR, 'ReactionWheel_F412/Core/Src/Application/Control/Controllers/CT_LoggingPayload.yaml')

def main():
    '''Read serial data from HC-05 and optionally log to file and/or view live with Rerun.'''

    global LOG_PATH
    global BL_CONFIG_PATH
    
    parser = argparse.ArgumentParser(description='Read from HC-05 serial and log frames')
    parser.add_argument('--port', '-p', default='/dev/cu.HC-05')
    parser.add_argument('--baud', '-b', type=int, default=460800)
    parser.add_argument('--log', '-l', action="store_true", help='Enable logging to file')
    parser.add_argument('--view', '-v', action="store_true", help='Enable live viewing with Rerun')
    parser.add_argument('--log_path', '-o', type=str, default=LOG_PATH)

    args = parser.parse_args()
    port = args.port
    baud = args.baud
    logging = args.log
    viewing = args.view
    LOG_PATH = args.log_path

    # Initialize frame handler
    frame_handler = BLFrameHandler(BL_CONFIG_PATH)

    # Get the log_frame instance
    log_frame = frame_handler.get_frame('log_frame')

    if log_frame is None:
        raise ValueError(f"log_frame definition not found in {BL_CONFIG_PATH}")

    # Open serial port
    ser = serial.Serial(port, baud, timeout=1)

    if viewing:
        # Initialize Rerun
        rr.init("Reaction_Wheel", spawn=True)

    # Begin reading and parsing data
    try:
        data_array = []
        buf = b''
        total_bytes = log_frame.total_length
        cnt = 0
        while True:
            data = ser.read(256)
            if not data:
                continue
            buf += data
            while len(buf) >= total_bytes:
                # Extract one full frame
                frame = buf[:total_bytes]
                
                # Remove extracted frame from buffer
                buf = buf[total_bytes:]

                # Parse frame
                parsed = log_frame.unpack(frame)
                if parsed:
                    cnt += 1
                    print(f'Frames Recieved: {cnt}', end='\r')

                    if viewing:
                        # Log all signals to Rerun
                        for key, value in parsed.items():
                            if key == 't':
                                continue
                            rr.log(f"signal/{key}", rr.Scalars(value))

                    if logging:
                        # Append to data array for logging
                        data_array.append(parsed)
                        
    except KeyboardInterrupt:
        print('\n\nExiting…')
        print('May be prompted for sudo password to hang up bluetooth.')
    finally:
        ser.close()

        if logging and data_array:
            # Write recorded data to parquet file
            print(f'\nCollected {len(data_array)} frames.')
            df = pd.DataFrame(data_array)
            df['t'] = df['t'] - df['t'][0]

            # Add datetime column based on t
            # Needed to get rerun compatible timestamps
            start_time = datetime.datetime.now()
            df["datetime"] = df["t"].apply(lambda ms: start_time + datetime.timedelta(milliseconds=ms))

            df.to_parquet(LOG_PATH, index=True)
            print(f'Wrote log to {LOG_PATH}')
        
        # Hard hang up bluetooth, otherwise it may not reconnect
        os.system('sudo pkill -f bluetooth')

if __name__ == '__main__':
    main()
