austynloehr/stm32_reaction_wheel/(commit log)

2023-07-19 Initial commit with working build and updated architecture
    [mpu6050_ble_test (1).cfg]
2023-07-21 Added working test software to main firmware structure.
    [STM32ReactionWheel.cfg]
2023-08-20 Remade project after computer reset. Updated script documation.
    [STM32ReactionWheel.cfg]
2023-09-21 Impletmented real-time complimentary filter for MPU6050 data
2023-09-28 Added Schematic.drawio
2023-09-28 Created baseline schematic
2023-09-29 Added power and motor control to schematics
2023-10-01 Added datasheets for chosen motor and motor controller.
2023-10-03 Designed initial test schematic.drawio
2023-10-03 Configured outputs for test motor setup
2023-12-05 Feature/4 develop motor controller api (#13)
    * Organized Resources folder
    * Created inverted pendulum simulink model
    * Added docs for new motor and controller. Added some logic to control initialization angle and gyro reset angle.
    * Moved location of new motor and controller Datasheets
    * Got code working for new STM32F407 project
    * Added CANalyzer project files
    * Created VESC CAN driver. Added functionality to drive with IMU.
    * Added F407 eval board Datasheet
    * Updated main README
    ---------
    [VESC.cfg]
2024-02-08 Feature/14 pcb design (#16)
    * Checking in prototype desgn progress
    * Completed first pass at PCB schematic
    * Schematic formatting clean up, added TVS diode to LED PWM
    * Schematic revisions after review
    * First pass at PCB layout and routing
    * Added final pcb design and manufacturing files
    * Moved old firmware to testing folder
    * Updated README for latest hardware
    [10-84-4020.stp, 10-84-4030.stp, 1314-0016-0006.prt, 1314-0016-0250 assembly.STEP, 1314-0016-0250.prt, 1521-0008-0020.STEP, 1521-0008-0020.prt, 1611-0514-0006.prt]
2024-02-11 Renamed pcb files and moved to Hardware folder. Cleaned up component paths.
    [10-84-4020.stp, 10-84-4030.stp, 2159151002.stp, 3568.stp, AYZ0102AURLC.stp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]
2024-03-23 17 revise balance controller pcb (#18)
    * Added LED board progress
    * Updated schematic and routing
    * Created updated BOM and manufacturing files
    * Updated XT60 PN and added render
    [Balance_Controller-B_Cu.gbl, Balance_Controller-B_Cu.gbr, Balance_Controller-B_Mask.gbr, Balance_Controller-B_Mask.gbs, Balance_Controller-B_Paste.gbp, Balance_Controller-B_Paste.gbr, Balance_Controller-B_Silkscreen.gbo, Balance_Controller-B_Silkscreen.gbr]
2024-03-23 Created lighter weight CAD model for Balance_Controller
2024-12-26 Feature/7 design and 3d print prototype chassis (#19)
    * Checkin battery bracket progress
    * Redesigned chassis for version 3
    * Removed design folder
    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
    [1314-0016-0006.prt, 1314-0016-0250 assembly.STEP, 1314-0016-0250.prt, 1521-0008-0020.STEP, 1521-0008-0020.prt, 1606-0043-0250.prt, 1611-0514-0006.prt, 1621-1632-0006.prt]
2025-01-02 Feature/5 implement balance control (#20)
    * Added Schematic.drawio
    * Created baseline schematic
    * Added power and motor control to schematics
    * Added datasheets for chosen motor and motor controller.
    * Designed initial test schematic.drawio
    * Configured outputs for test motor setup
    * Added simulink changes
    Added STM32_Reaction_Wheel_Architecture.drawio.png
    Added STM32_Reaction_Wheel_Architecture-IO.drawio.png
    Added STM32_Reaction_Wheel_Architecture-IO.drawio.png
    Update STM32_Reaction_Wheel_Architecture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
    [MPM3606AGQV.step, RGB_LED.kicad_pcb, RGB_LED.kicad_sch, VESC.cfg, mpu6050_ble_test (1).cfg]
2025-10-05 Read logging frame format from yaml file. Can read and unpack bt log frames.
2025-10-05 Moved logging frame description to src near CT_logging.
2025-10-05 Force error if serial port cant open
    [read_bt_data.py]
