austynloehr/stm32_reaction_wheel/(notices)

Notices in the files:
ReactionWheel_F412/Core/Inc/main.h:
Copyright (c) 2023 STMicroelectronics.
All rights reserved.
This software is licensed under terms that can be found in the LICENSE file
Hardware/Balance_Controller/Components/LIB_AYZ0102AURLC/AYZ0102AURLC/3D/AYZ0102AURLC.stp:
author */ ('License CC BY-ND 4.0'),
